tomcircuit/lavalamp/media/LavaLamp_APA102_3dview.png

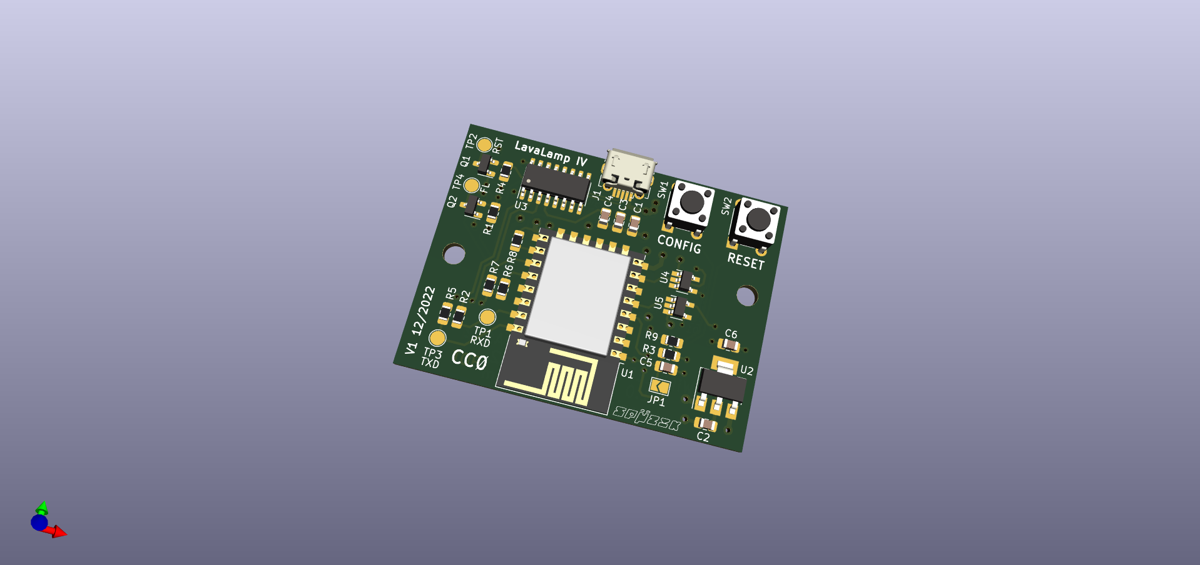
media/LavaLamp_APA102_3dview.png
