tomcircuit/lavalamp/media/LavaLamp_APA102_ledside.png

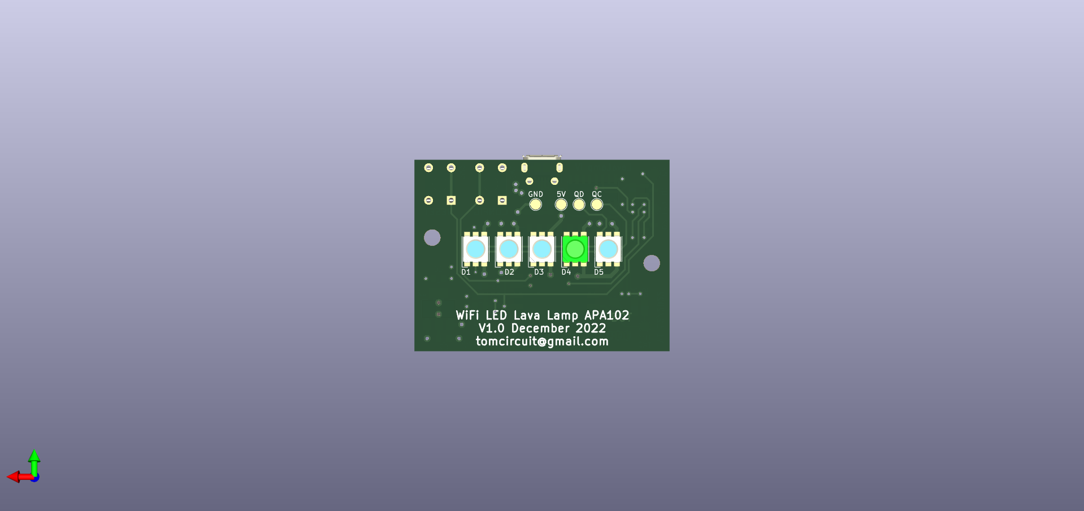
media/LavaLamp_APA102_ledside.png
