tomcircuit/lavalamp/hardware/Sine Lookup Table.xls

 | AMPLITUDE |  | 120
 | OFFSET |  | 135
Step | Angle | Sin | Dec | Hex | Radix
0 | 0 | 0 | 135 | 87 | 0x87, | 0x87, 0x8C, 0x92, 0x98, 0x9E, 0xA4, 0xA9, 0xAF,
1 | 0.04908738521 | 0.04906767433 | 140 | 8C | 0x8C, | 0xB4, 0xBA, 0xBF, 0xC4, 0xC9, 0xCE, 0xD3, 0xD7,
2 | 0.09817477042 | 0.09801714033 | 146 | 92 | 0x92, | 0xDB, 0xDF, 0xE3, 0xE7, 0xEA, 0xED, 0xF0, 0xF3,
3 | 0.1472621556 | 0.1467304745 | 152 | 98 | 0x98, | 0xF5, 0xF7, 0xF9, 0xFB, 0xFC, 0xFD, 0xFE, 0xFE,
4 | 0.1963495408 | 0.195090322 | 158 | 9E | 0x9E, | 0xFF, 0xFE, 0xFE, 0xFD, 0xFC, 0xFB, 0xF9, 0xF7,
5 | 0.2454369261 | 0.2429801799 | 164 | A4 | 0xA4, | 0xF5, 0xF3, 0xF0, 0xED, 0xEA, 0xE7, 0xE3, 0xDF,
6 | 0.2945243113 | 0.2902846773 | 169 | A9 | 0xA9, | 0xDB, 0xD7, 0xD3, 0xCE, 0xC9, 0xC4, 0xBF, 0xBA,
7 | 0.3436116965 | 0.3368898534 | 175 | AF | 0xAF, | 0xB4, 0xAF, 0xA9, 0xA4, 0x9E, 0x98, 0x92, 0x8C,
8 | 0.3926990817 | 0.3826834324 | 180 | B4 | 0xB4, | 0x87, 0x82, 0x7C, 0x76, 0x70, 0x6A, 0x65, 0x5F,
9 | 0.4417864669 | 0.4275550934 | 186 | BA | 0xBA, | 0x5A, 0x54, 0x4F, 0x4A, 0x45, 0x40, 0x3B, 0x37,
10 | 0.4908738521 | 0.4713967368 | 191 | BF | 0xBF, | 0x33, 0x2F, 0x2B, 0x27, 0x24, 0x21, 0x1E, 0x1B,
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
