tomcircuit/lavalamp/hardware/Output/Bottom_Copper.pdf

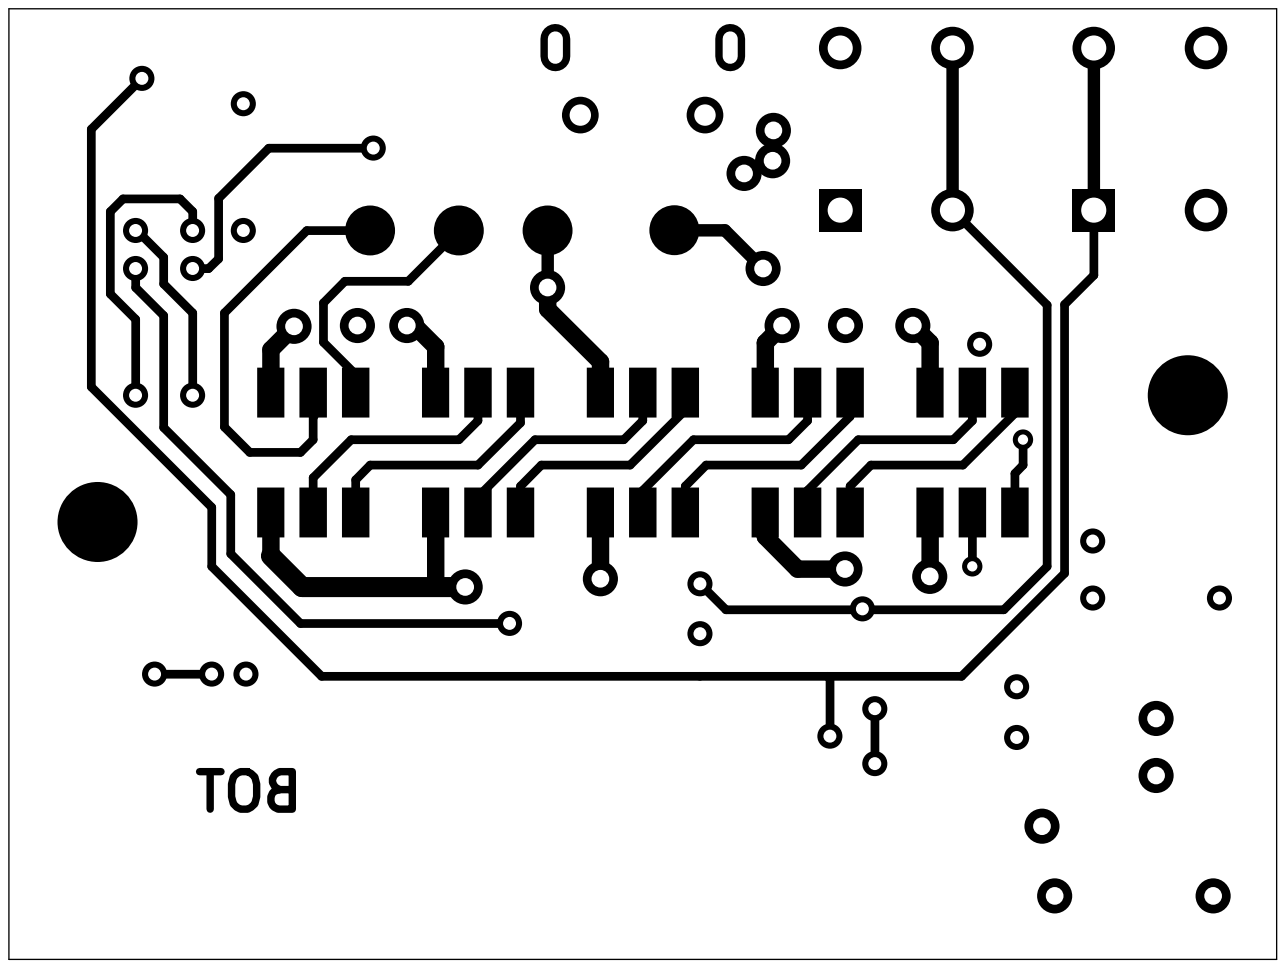
[picture p3: page 1]
