tomcircuit/lavalamp/hardware/Output/Bottom_Copper_mirror.pdf

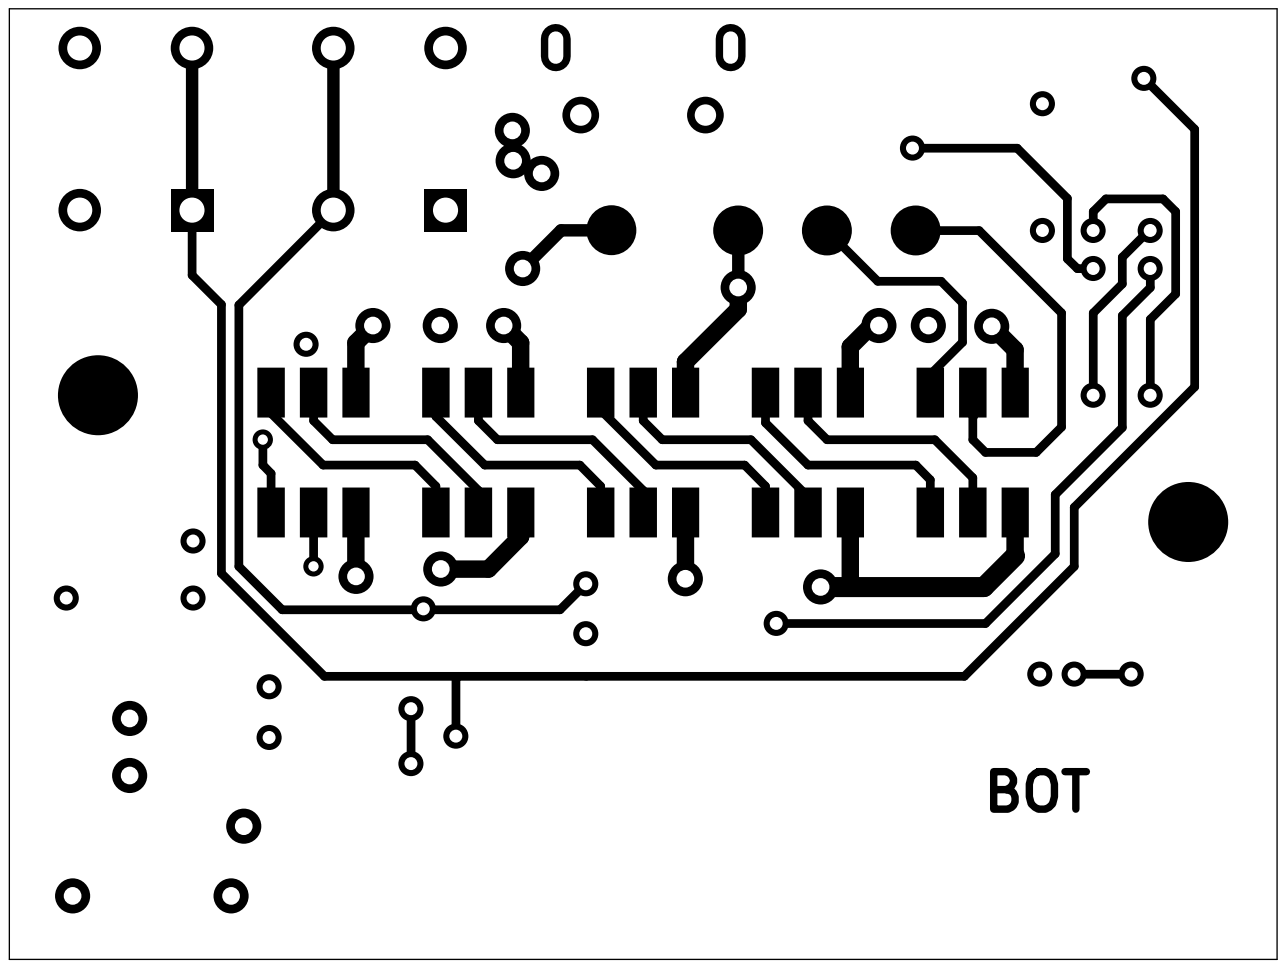
[picture p4: page 1]
