tomcircuit/lavalamp/hardware/Output/Bottom_Fabrication.pdf

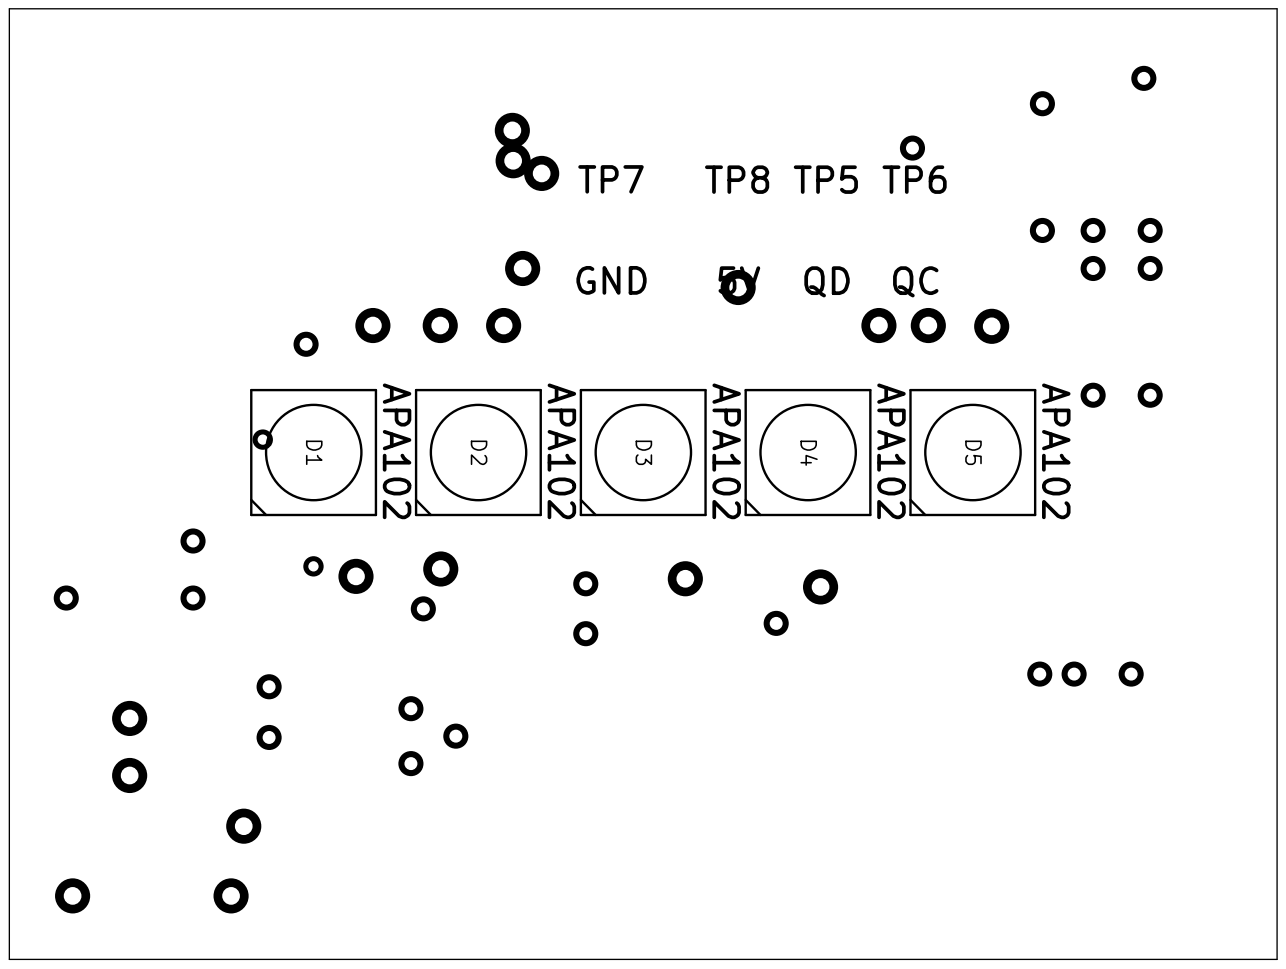
[picture p5: page 1]
