tomcircuit/lavalamp/hardware/Output/Bottom_View.pdf

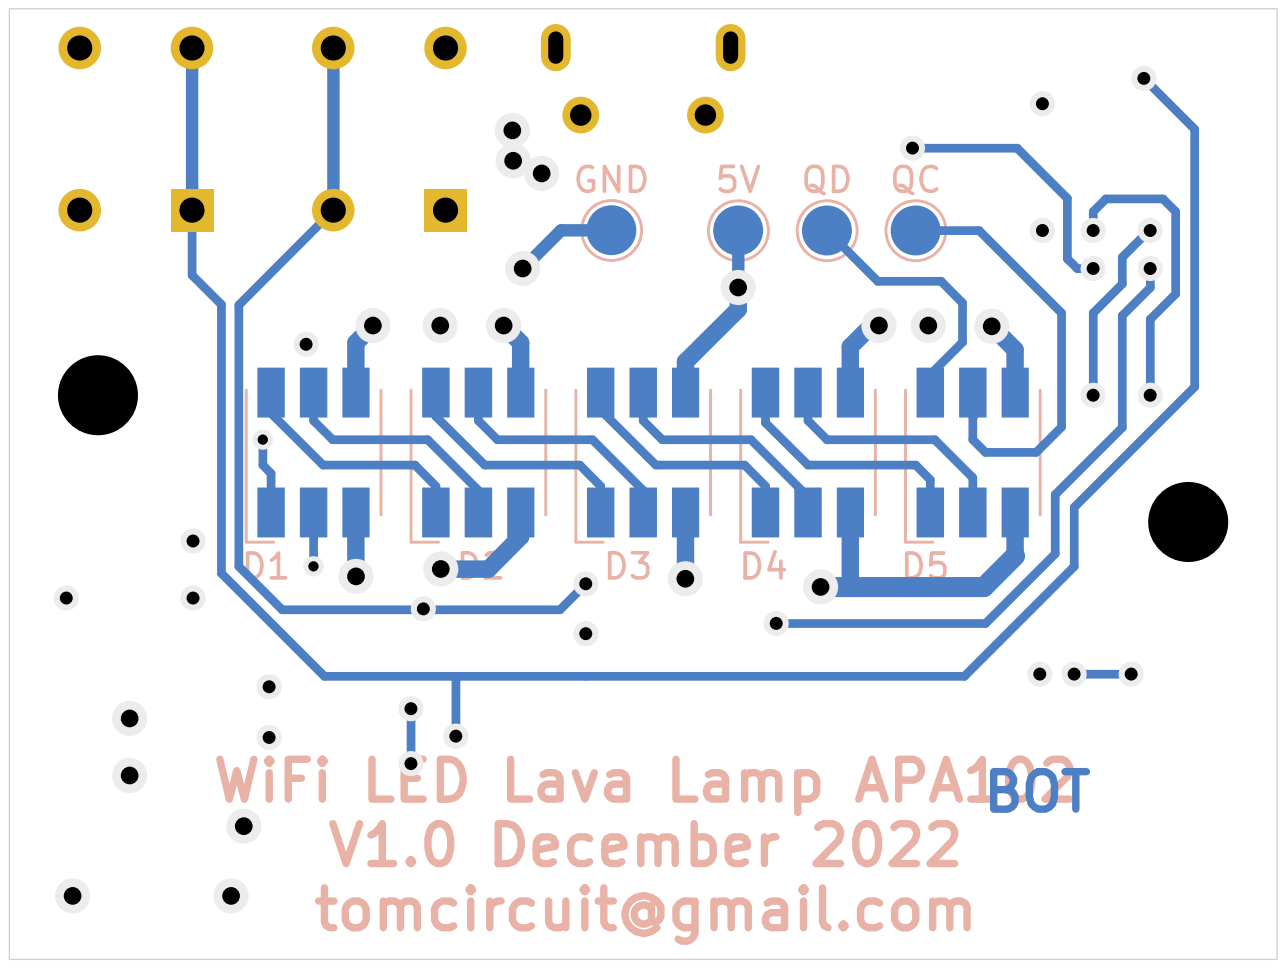
[picture p6: page 1]
