tomcircuit/lavalamp/hardware/Output/Fabrication Overview.pdf

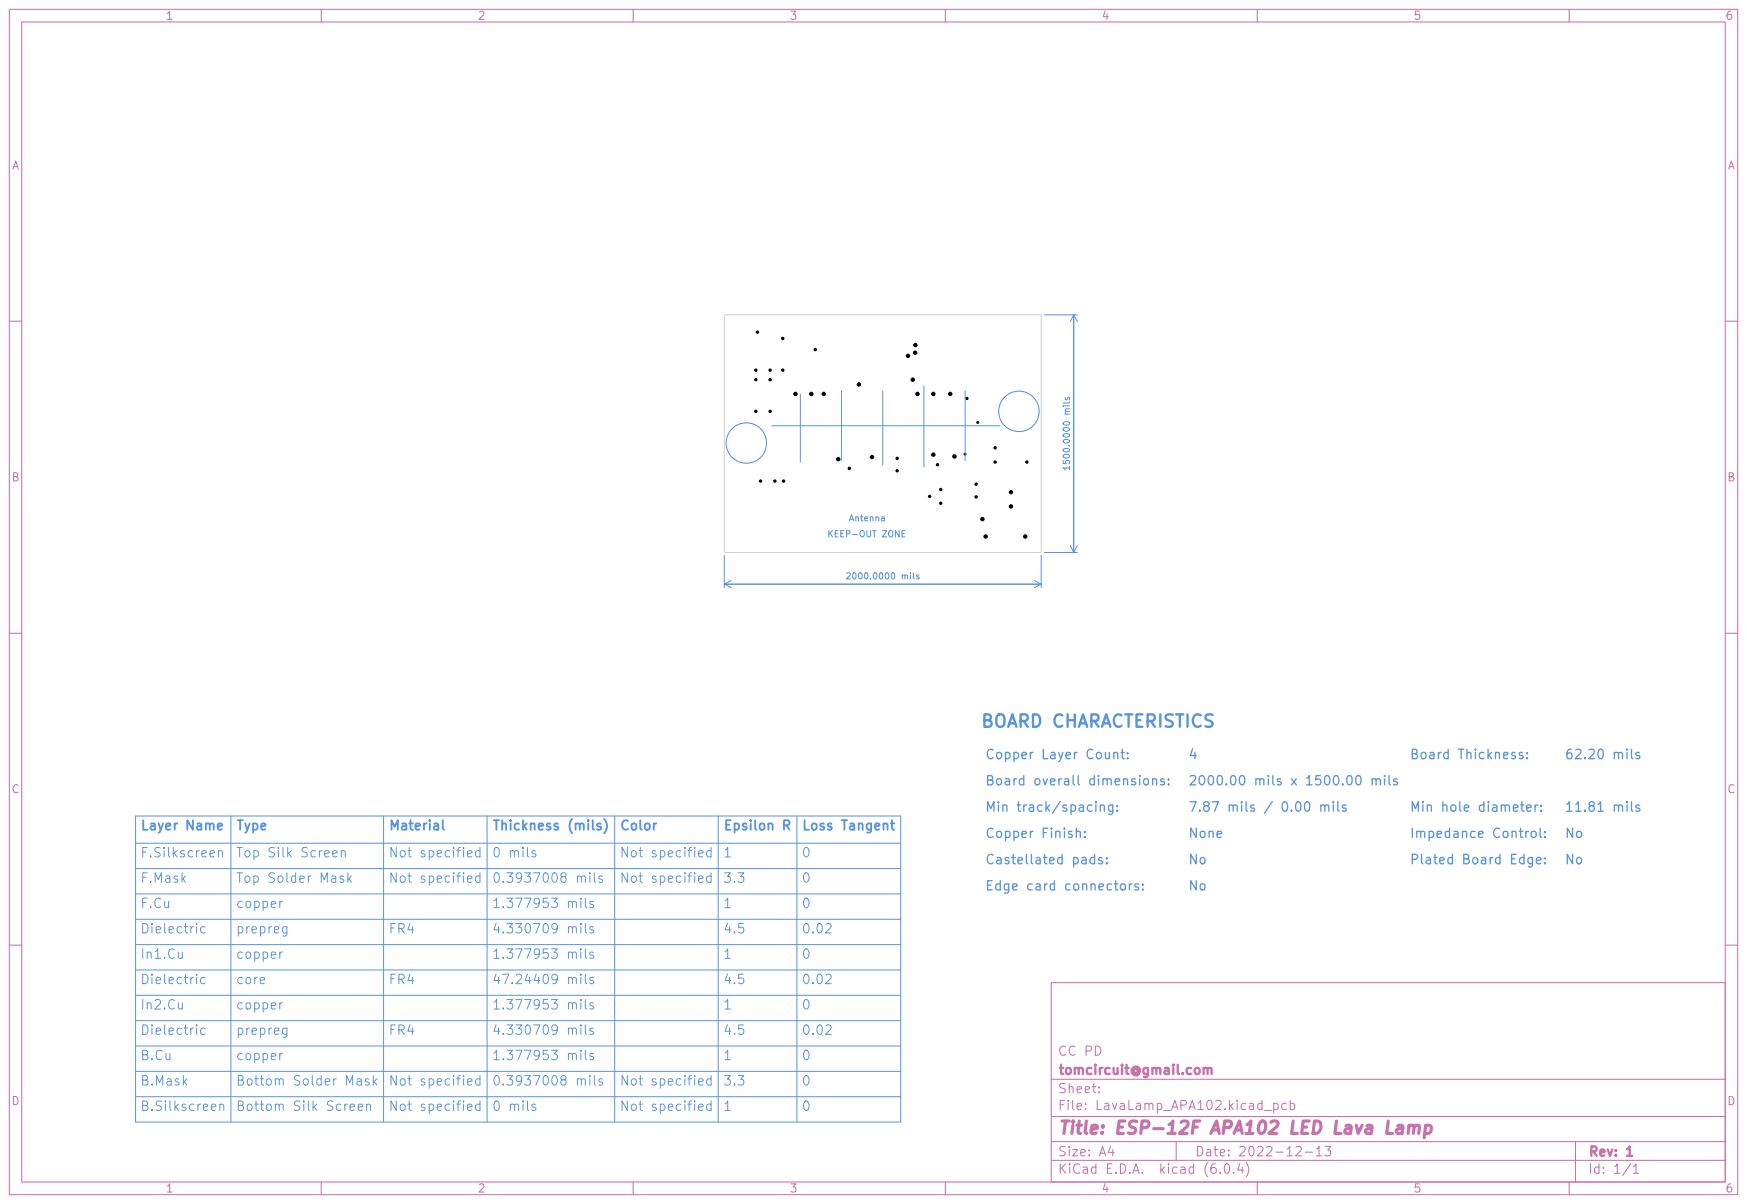
[picture p7: page 1]
