tomcircuit/lavalamp/hardware/Output/Internal1_Copper.pdf

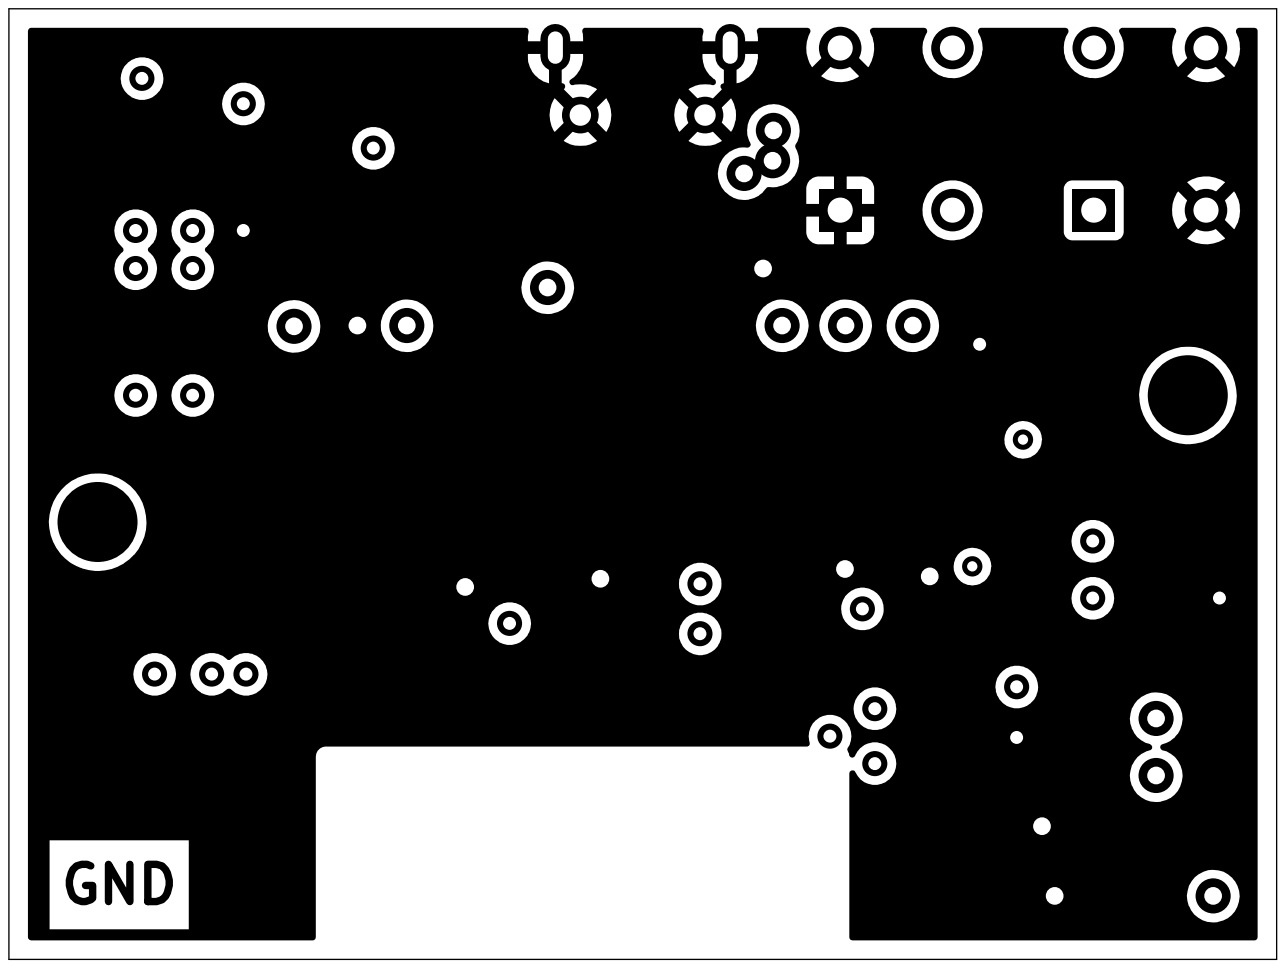
[picture p8: page 1]
