tomcircuit/lavalamp/hardware/Output/Internal2_Copper.pdf

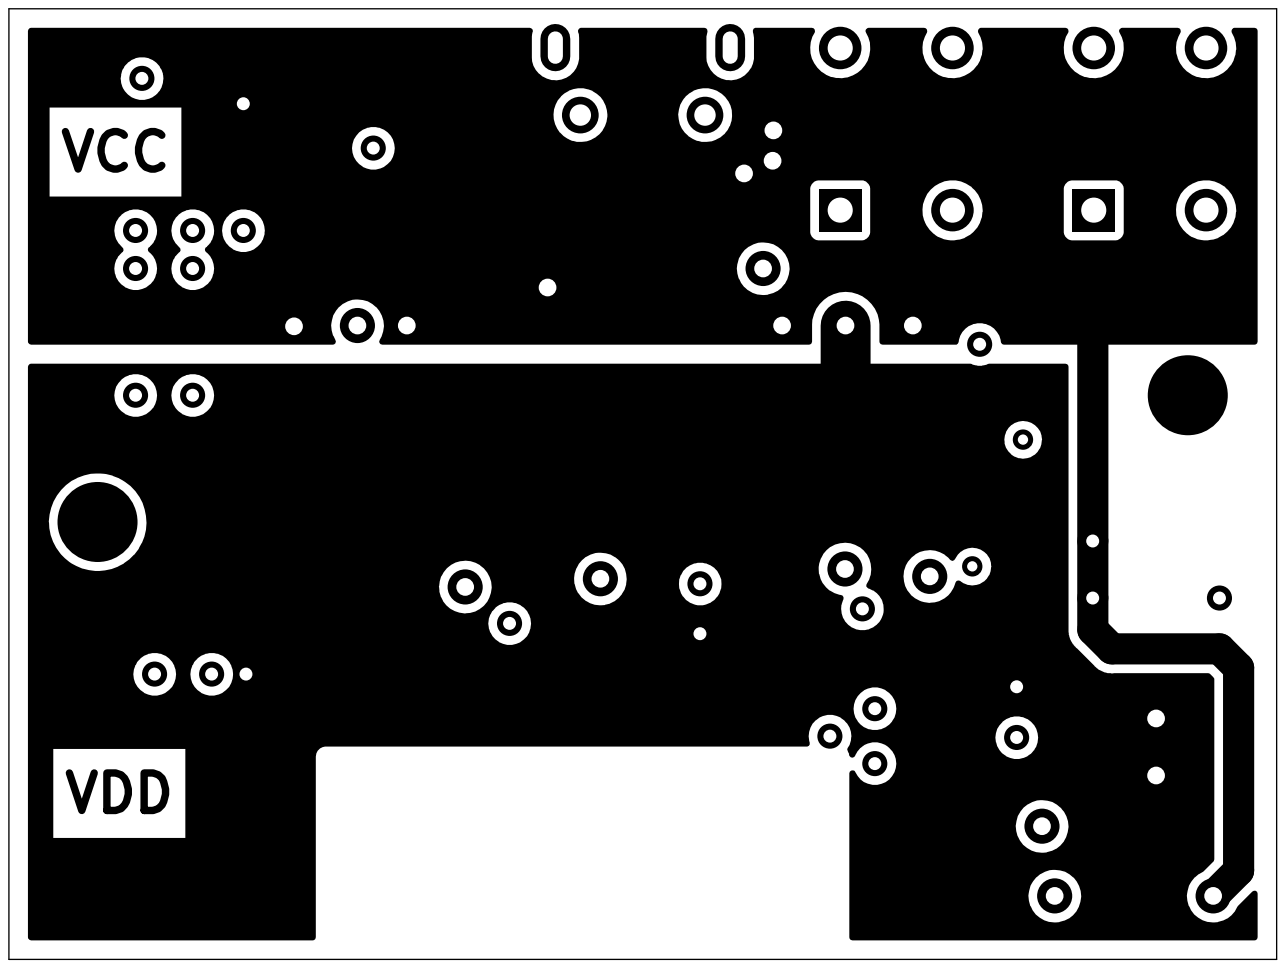
[picture p9: page 1]
