tomcircuit/lavalamp/hardware/Output/Schematic.pdf

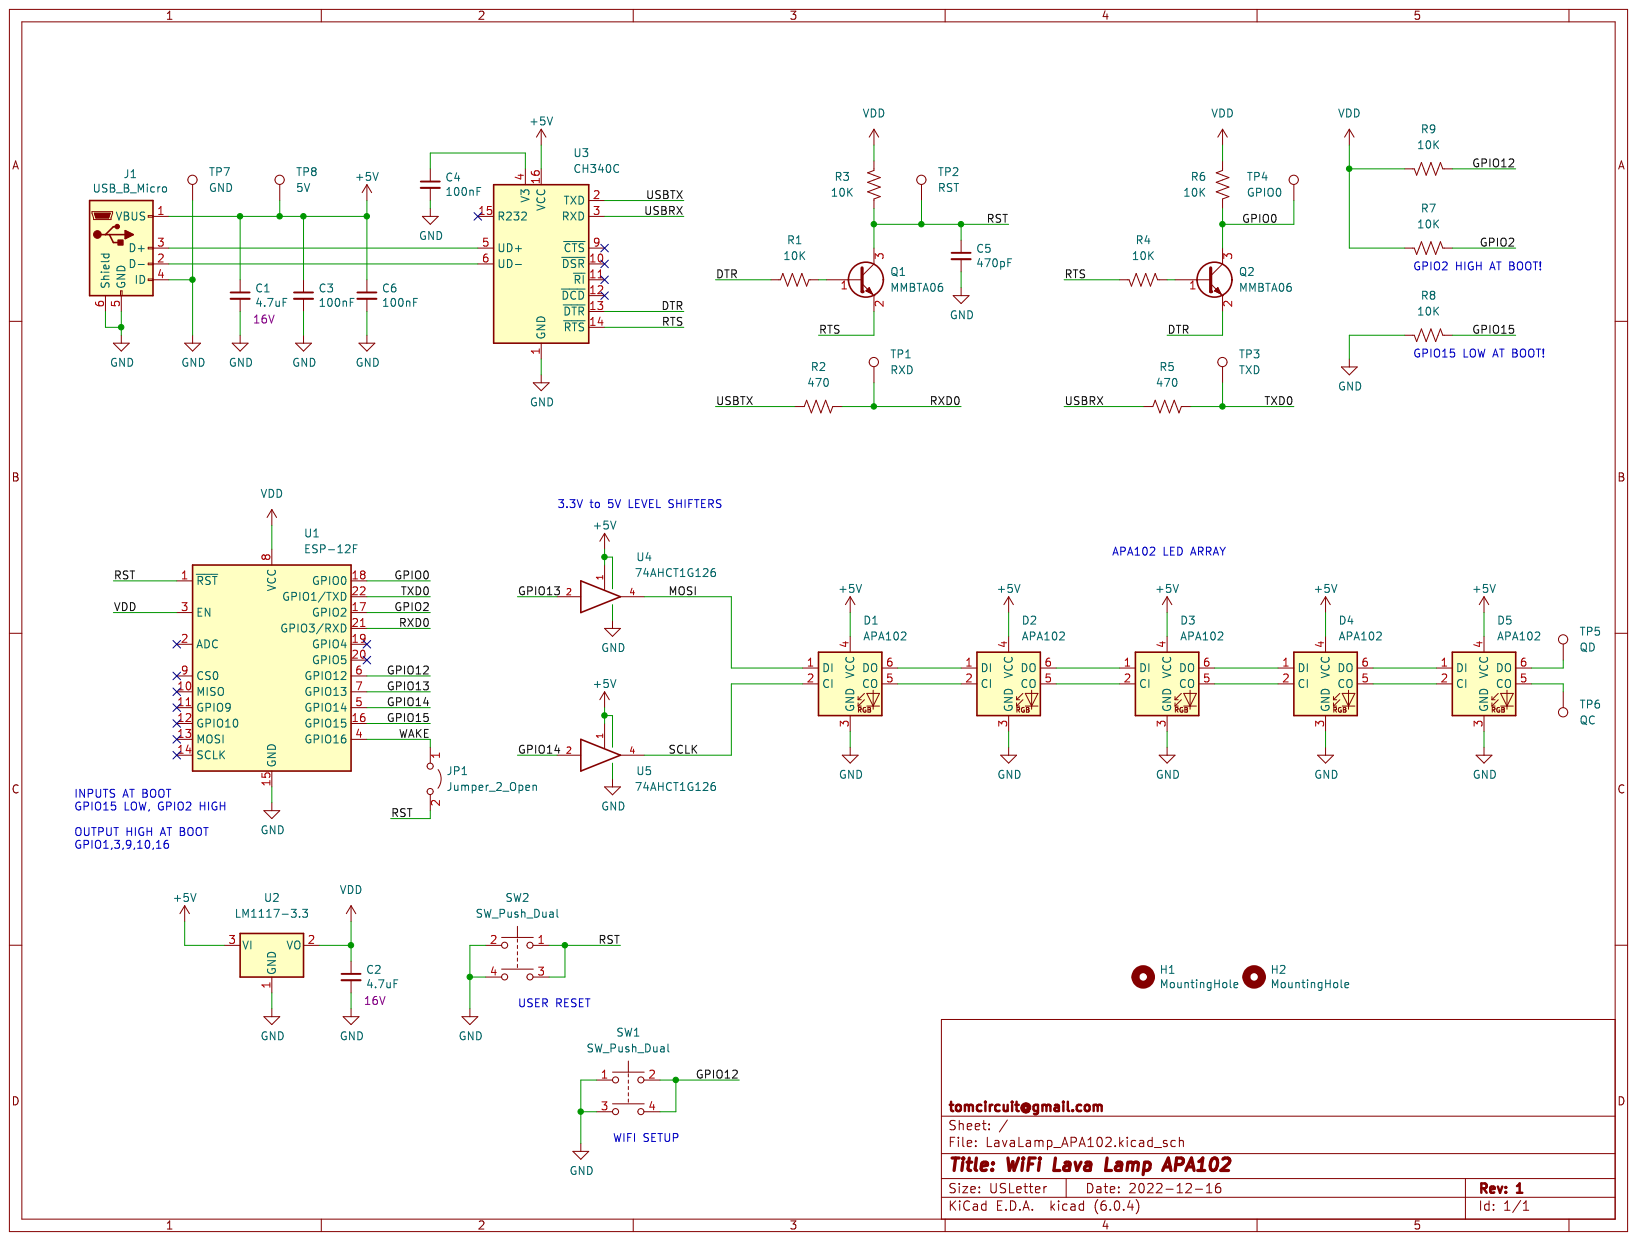
[picture p10: page 1]
