tomcircuit/lavalamp/hardware/Output/Top_Copper.pdf

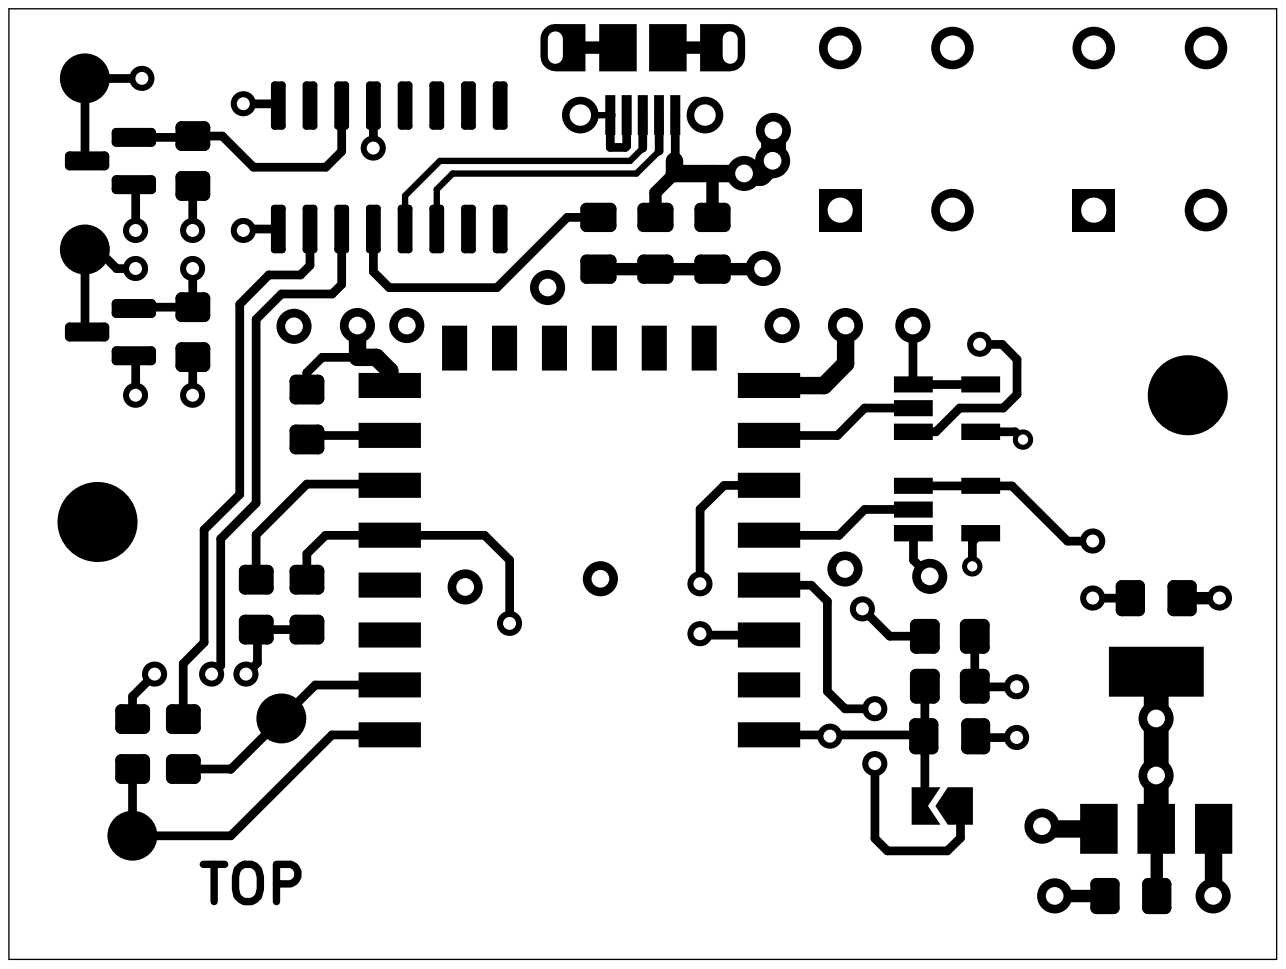
[picture p11: page 1]
