tomcircuit/lavalamp/hardware/Output/Top_Fabrication.pdf

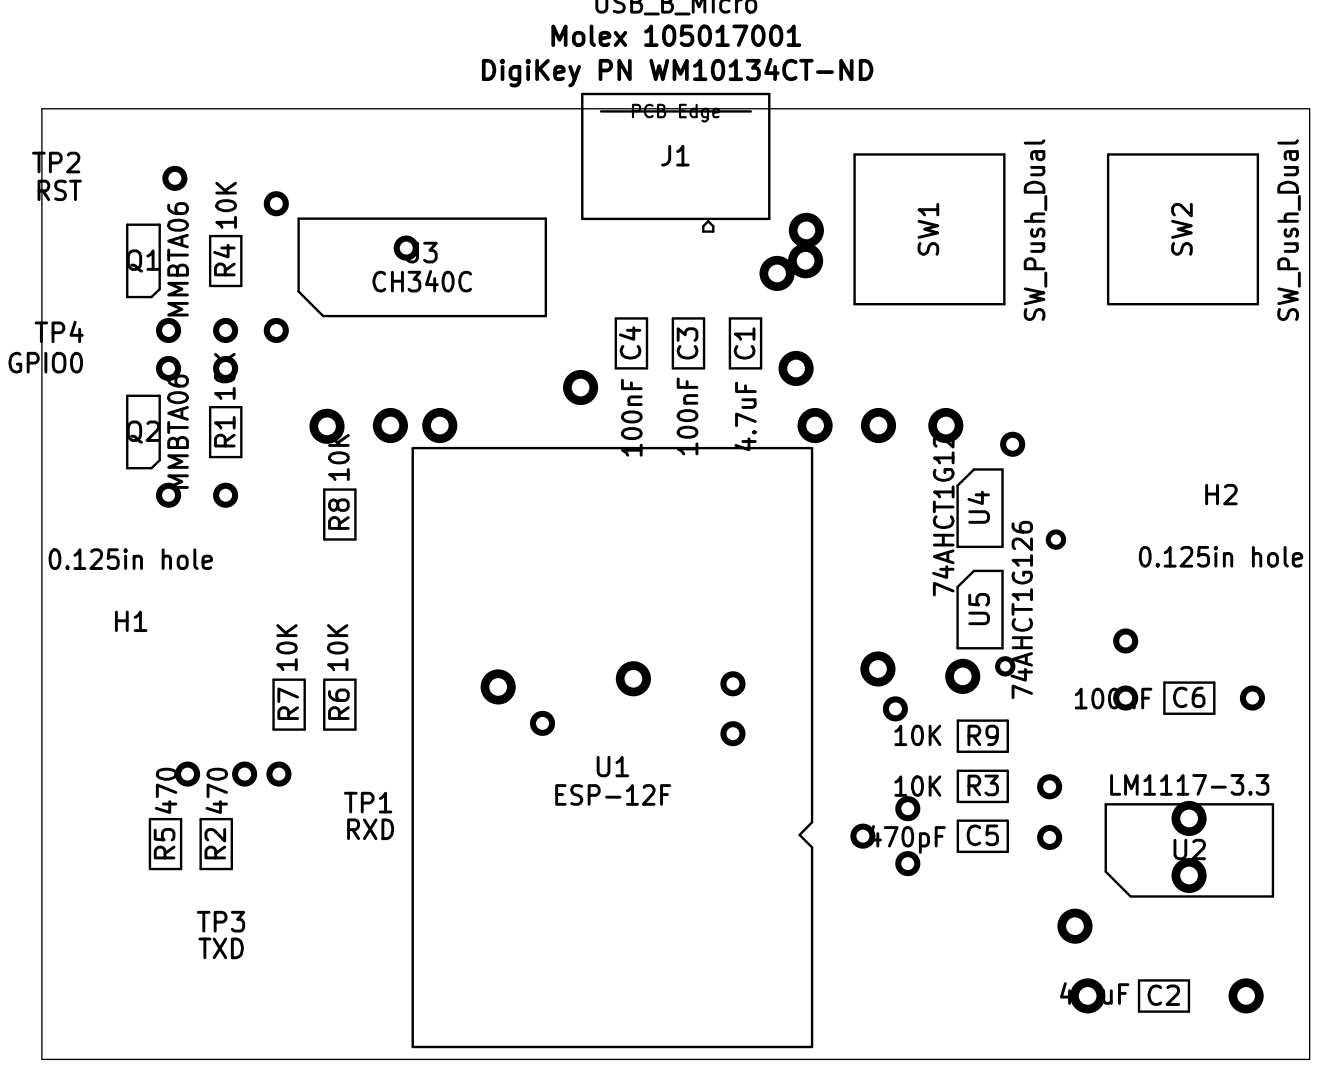
[picture p12: page 1]
