tomcircuit/lavalamp/hardware/Output/Top_View.pdf

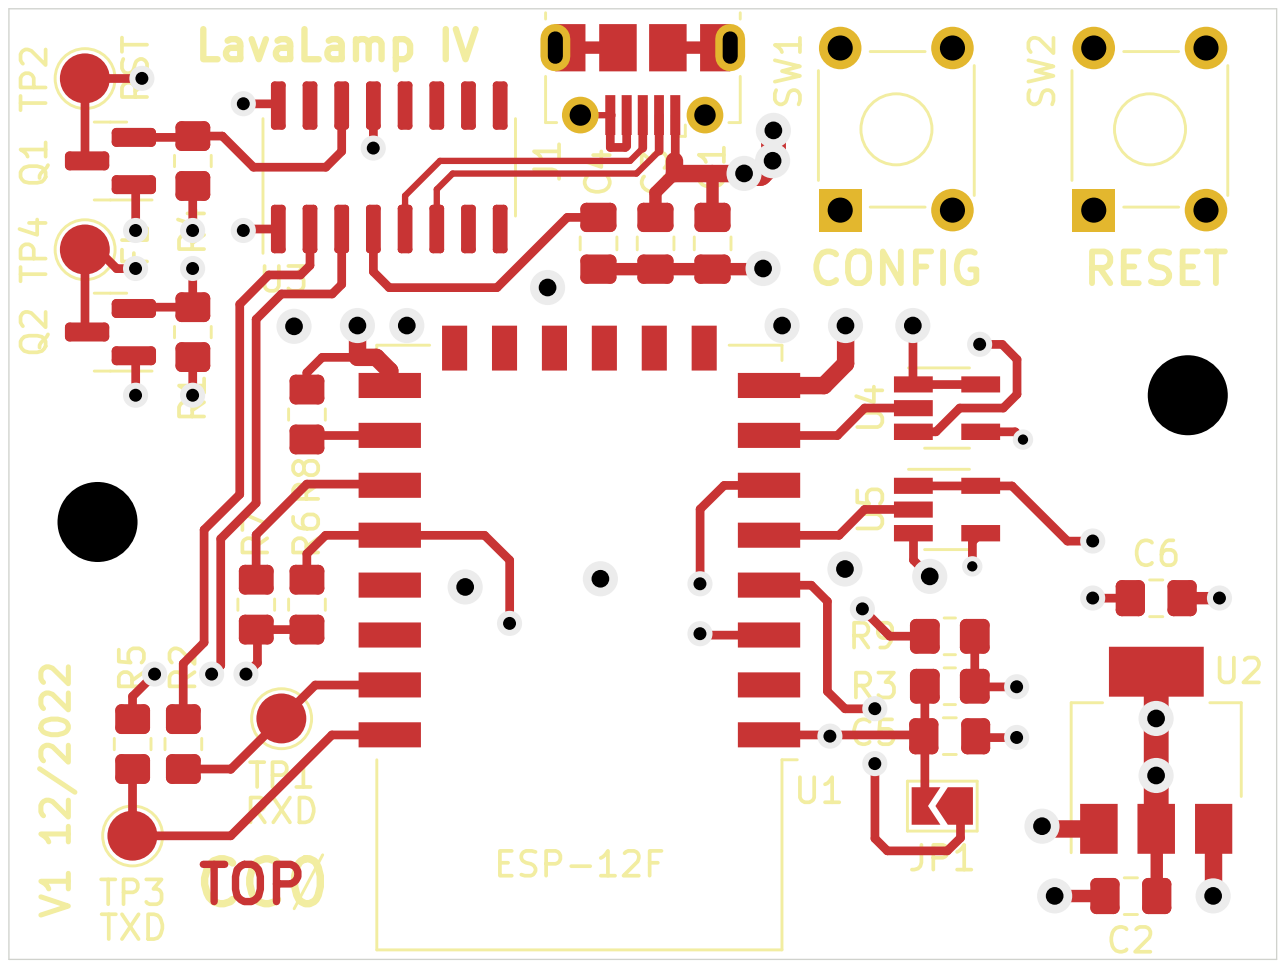
[picture p13: page 1]
