tomcircuit/lavalamp/hardware/LavaLamp_APA102.kicad_pcb

## KiCad design hardware/LavaLamp_APA102.kicad_pcb (2024-05-30)

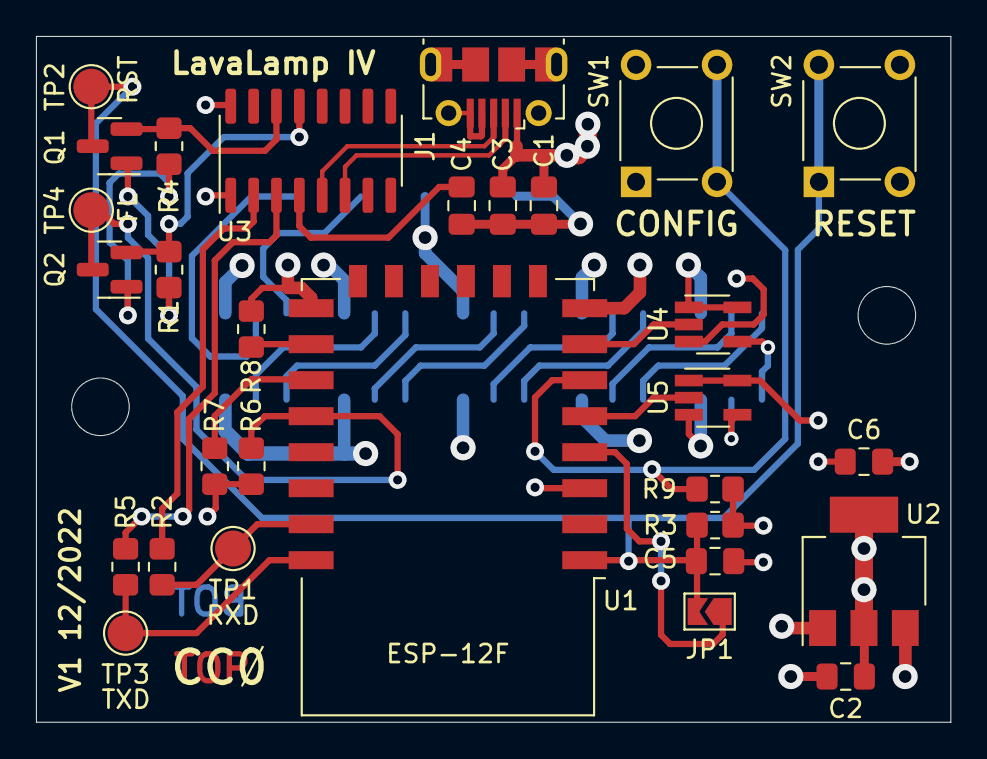
[picture p14: board LavaLamp_APA102.kicad_pcb from above]

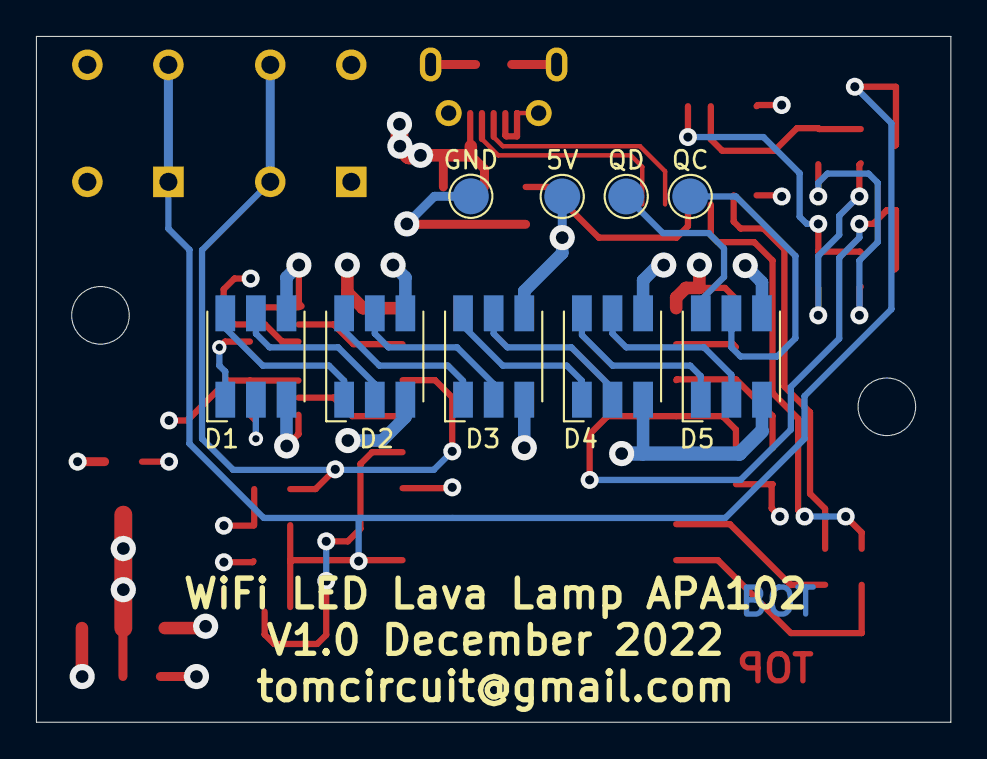
[picture p15: board LavaLamp_APA102.kicad_pcb from below]

Board: 4 copper layers, 50.8 x 38.1 mm, 41 parts (9 on the bottom side), 34 nets.

Parts:
C1, C2: 4.7uF; C_0805_2012Metric_Pad1.18x1.45mm_HandSolder
C3, C4, C6: 100nF; C_0805_2012Metric_Pad1.18x1.45mm_HandSolder
C5: 470pF; C_0805_2012Metric_Pad1.18x1.45mm_HandSolder
D1, D2, D3, D4, D5: APA102; LED_RGB_5050-6
H1, H2: 0.125in hole; MountingHole_3.2mm_M3
J1: USB_B_Micro; USB_Micro-B_Molex-105017-0001
JP1: Jumper_2_Open; SolderJumper-2_P1.3mm_Open_TrianglePad1.0x1.5mm
Q1, Q2: MMBTA06; SOT-23
R1, R3, R4, R6, R7, R8, R9: 10K; R_0805_2012Metric_Pad1.20x1.40mm_HandSolder
R2, R5: 470; R_0805_2012Metric_Pad1.20x1.40mm_HandSolder
SW1, SW2: SW_Push_Dual; SW_TH_Tactile_Omron_B3F-10xx
TP1: RXD; TestPoint_Pad_D2.0mm
TP2: RST; TestPoint_Pad_D2.0mm
TP3: TXD; TestPoint_Pad_D2.0mm
TP4: GPIO0; TestPoint_Pad_D2.0mm
TP5: QD; TestPoint_Pad_D2.0mm
TP6: QC; TestPoint_Pad_D2.0mm
TP7: GND; TestPoint_Pad_D2.0mm
TP8: 5V; TestPoint_Pad_D2.0mm
U1: ESP-12F; ESP-12E
U2: LM1117-3.3; SOT-223-3_TabPin2
U3: CH340C; SOIC-16_3.9x9.9mm_P1.27mm
U4, U5: 74AHCT1G126; SOT-23-5_HandSoldering

Connections:
+5V: C1.1, C3.1, C6.1, D1.4 (VCC), D2.4 (VCC), D3.4 (VCC), D4.4 (VCC), D5.4 (VCC), J1.1 (VBUS), TP8.1, U2.3 (VI), U3.16 (VCC), U4.1, U4.5 (VCC), U5.1, U5.5 (VCC)
/DTR: Q2.2 (E), R1.1, U3.13 (~DTR)
/GPIO0: Q2.3 (C), R6.1, TP4.1, U1.18 (GPIO0)
/GPIO2: R7.2, U1.17 (GPIO2)
/GPIO12: R9.2, SW1.2, U1.6 (GPIO12)
/GPIO13: U1.7 (GPIO13), U4.2
/GPIO14: U1.5 (GPIO14), U5.2
/GPIO15: R8.2, U1.16 (GPIO15)
/MOSI: D1.1 (DI), U4.4
/RST: C5.1, JP1.2 (B), Q1.3 (C), R3.1, SW2.1, TP2.1, U1.1 (~RST)
/RTS: Q1.2 (E), R4.1, U3.14 (~RTS)
/RXD0: R2.2, TP1.1, U1.21 (GPIO3/RXD)
/SCLK: D1.2 (CI), U5.4
/TXD0: R5.2, TP3.1, U1.22 (GPIO1/TXD)
/USBRX: R5.1, U3.3 (RXD)
/USBTX: R2.1, U3.2 (TXD)
/WAKE: JP1.1 (A), U1.4 (GPIO16)
GND: C1.2, C2.2, C3.2, C4.2, C5.2, C6.2, D1.3 (GND), D2.3 (GND), D3.3 (GND), D4.3 (GND), D5.3 (GND), J1.4 (ID), J1.5 (GND), J1.6 (Shield), R8.1, SW1.1, SW2.2, TP7.1, U1.15 (GND), U2.1 (GND), U3.1 (GND), U4.3 (GND), U5.3 (GND)
unnamed: C4.1, U3.4 (V3)
unnamed: D1.5 (CO), D2.2 (CI)
unnamed: D1.6 (DO), D2.1 (DI)
unnamed: D2.5 (CO), D3.2 (CI)
unnamed: D2.6 (DO), D3.1 (DI)
unnamed: D3.5 (CO), D4.2 (CI)
unnamed: D3.6 (DO), D4.1 (DI)
unnamed: D4.5 (CO), D5.2 (CI)
unnamed: D4.6 (DO), D5.1 (DI)
unnamed: D5.5 (CO), TP6.1
unnamed: D5.6 (DO), TP5.1
unnamed: J1.2 (D-), U3.6 (UD-)
unnamed: J1.3 (D+), U3.5 (UD+)
unnamed: Q1.1 (B), R1.2
unnamed: Q2.1 (B), R4.2
VDD: C2.1, R3.2, R6.2, R7.1, R9.1, U1.3 (EN), U1.8 (VCC), U2.2 (VO)
