tomcircuit/lavalamp/software/test2_APA102_access/test2_APA102_access.ino

/* LED LAVA LAMP test program #2 - APA102 access  
*  Make an LED pattern with a large dynamic range using the 
 * extra 5-bit brightness register in the APA102.
 *
 * It sets every LED on the strip to white, with *a dim*
 *  white at the input end of the strip and the brightest
 * possible white at the other end, and a smooth logarithmic
 * gradient between them.
 *
 * The *dim* white is achieved by setting the red,
 * green, and blue color channels to 1, and setting the
 * brightness register to 1.  The brightest possibe white is
 * achieved by setting the color channels to 255 and setting the
 * brightness register to 31.
 */

/* By default, the APA102 library uses pinMode and digitalWrite
 * to write to the LEDs, which works on all Arduino-compatible
 * boards but might be slow.  If you have a board supported by
 * the FastGPIO library and want faster LED updates, then install
 * the FastGPIO library and uncomment the next two lines: */
// #include <FastGPIO.h>
// #define APA102_USE_FAST_GPIO

#include <APA102.h>

// Define which pins to use.
const uint8_t dataPin = 13;
const uint8_t clockPin = 14;

// Create an object for writing to the LED strip.
APA102<dataPin, clockPin> ledStrip;

// Set the number of LEDs to control.
const uint16_t ledCount = 5;

// We define "power" in this sketch to be the product of the
// 8-bit color channel value and the 5-bit brightness register.
// The maximum possible power is 255 * 31 (7905).
const uint16_t maxPower = 255 * 31;

// The power we want to use on the first LED is 255, which
// corresponds to *a dim* white.
const uint16_t minPower = 255;

// Calculate what the ratio between the powers of consecutive
// LEDs needs to be in order to reach the max power on the last
// LED of the strip.
const float multiplier = pow(maxPower / minPower, 1.0 / (ledCount - 1));

void setup()
{
}

// This function sends a white color with the specified power,
// which should be between 0 and 7905.
void sendWhite(uint16_t power)
{
  // Choose the lowest possible 5-bit brightness that will work.
  uint8_t brightness5Bit = 1;
  while(brightness5Bit * 255 < power && brightness5Bit < 31)
  {
    brightness5Bit++;
  }

  // Uncomment this line to simulate an LED strip that does not
  // have the extra 5-bit brightness register.  You will notice
  // that roughly the first third of the LED strip turns off
  // because the brightness8Bit equals zero.
  //brightness = 31;

  // Set brightness8Bit to be power divided by brightness5Bit,
  // rounded to the nearest whole number.
  uint8_t brightness8Bit = (power + (brightness5Bit / 2)) / brightness5Bit;

  // Send the white color to the LED strip.  At this point,
  // brightness8Bit multiplied by brightness5Bit should be
  // approximately equal to power.
  ledStrip.sendColor(brightness8Bit, brightness8Bit, brightness8Bit, brightness5Bit);
}

void loop()
{
  ledStrip.startFrame();
  float power = minPower;
  for(uint16_t i = 0; i < ledCount; i++)
  {
    sendWhite(power);
    power = power * multiplier;
  }
  ledStrip.endFrame(ledCount);
}
